satstep/satstep2660/media/noheat1.jpg

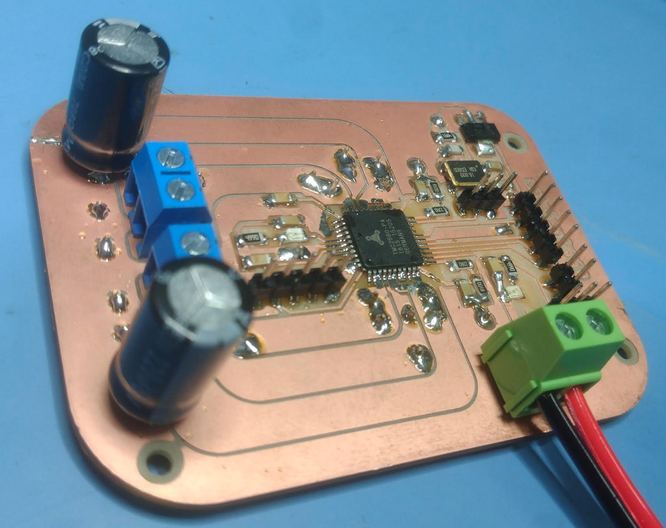
media/noheat1.jpg
