satstep/satstep2660/bom/satstep2660 BOM.ods

Value | Manufacturer Part No | Package | Description | Link | Unit Price $ | Quantity | Price $ | Total price $:
- | TMC2660-PA-T | 44-LQFP | stepper driver IC | digikey (https://www.digikey.com/product-detail/en/trinamic-motion-control-gmbh/TMC2660-PA-T/1460-1062-1-ND/4500217) | 6.98 | 1 | 6.98 | 11.2161
470nF 100V | - | 1206 | smd capacitor | aliexpress (https://www.aliexpress.com/item/100pcs-1206-470nF-0-47uF-100V-10-Thick-Film-Chip-Multilayer-Ceramic-Capacitor/32862247889.html) | 0.03 | 1 | 0.031
100nF 100V | - | 1206 | smd capacitor | aliexpress (https://www.aliexpress.com/item/Free-Shipping-100pcs-lot-1206-SMD-Capacitor-100V-100NF-10-X7R-CL31B104KCFNNNE/32751150463.html) | 0.06 | 3 | 0.1782
10nF 100V | - | 1206 | smd capacitor | aliexpress (https://www.aliexpress.com/item/100pcs-1206-10000pF-10nF-0-01uF-100V-10-Thick-Film-Chip-Multilayer-Ceramic-Capacitor/32860016976.html) | 0.03 | 4 | 0.12
220uF 63V | - | 10x16mm | trough hole capacitor | aliexpress (https://www.aliexpress.com/item/Free-Shipping-20PCS-Electrolytic-capacitor-63V-220UF-10x16mm/32234266260.html) | 0.12 | 2 | 0.239
15pF 100V | - | 1206 | smd capacitor | aliexpress (https://www.aliexpress.com/item/100pcs-1206-15PF-2KV-2000V-5-Thick-Film-Chip-Multilayer-Ceramic-Capacitor/32860906507.html) | 0.04 | 1 | 0.036
green | - | 1206 | smd led | aliexpress (https://www.aliexpress.com/item/Smd-leds-led-smd-red-ray-1206-languang-bright-double-red-red/2031685194.html) | 0.01 | 1 | 0.006
red | - | 1206 | smd led | aliexpress (https://www.aliexpress.com/item/Smd-leds-led-smd-red-ray-1206-languang-bright-double-red-red/2031685194.html) | 0.01 | 1 | 0.006
5V to 3.3V | MCP1703 | SOT223 | smd stepdown regulator | aliexpress (https://www.aliexpress.com/item/MCP1703T-3302E-DB-MCP1703T-3302E-D-MCP1703T-3302E-MCP1703T-3302-3302-10pcs-lot/32762444428.html) | 0.32 | 1 | 0.32
22 | - | 1206 | smd resistor | aliexpress (https://www.aliexpress.com/item/100PCS-1206-SMD-Resistor-5-22-ohm-220-22ohm-free-shipping/32881584288.html) | 0.01 | 2 | 0.0178
4.99K | - | 1206 | smd resistor | aliexpress (https://www.aliexpress.com/item/200pcs-1206-1-SMD-Resistor-4-99k-4-99K-ohm-Chip-Resistors-0-25W-1-4W/32956961040.html) | 0.01 | 1 | 0.01
499 | - | 1206 | smd resistor | aliexpress (https://www.aliexpress.com/item/200pcs-1206-1-SMD-Resistor-499R-499-ohms-ohm-Chip-Resistors-0-25W-1-4W/32960539874.html) | 0.01 | 2 | 0.02
0.1 | - | 1206 | smd resistor | aliexpress (https://www.aliexpress.com/item/200pcs-1-1206-SMD-resistor-0R-10M-1-4W-0-0-1-1-10-100-150/32844350889.html) | 0.01 | 2 | 0.02
16Mhz | XO91050UITA | 7 x 5mm SMD HCMOS | smd oscillator | farnell (https://www.newark.com/euroquartz/16-000mhz-xo91050uita/osc-5x7mm-smd-cer-16-000mhz/dp/15P4131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) | 2.84 | 1 | 2.84
2 poles | KF128-5.08-2P | 5.08mm | screw terminal block | aliexpress (https://www.aliexpress.com/item/100PCS-KF128-5-08-2P-KF128-2Pin-5-08mm-Straight-Pin-PCB-Screw-Terminal-Block-ROHS/32223216761.html) | 0.04 | 3 | 0.1161
40 poles | - | 2.54mm | straight pin headers | aliexpress (https://www.aliexpress.com/item/Free-Shipping-Pins-Multipurpose-Male-Male-5-strips-of-40/32651418137.html) | 0.15 | 1 | 0.146
- | - | 14x14x8mm | aluminum heatsink | aliexpress (https://www.aliexpress.com/item/10pcs-Computer-Cooler-Radiator-Aluminum-Heatsink-Heat-sink-for-Electronic-Chip-Heat-dissipation-Cooling-Pads-14/32890197245.html) | 0.13 | 1 | 0.13
