satstep/satstep2660/eagle/satstep2660.brd

## EAGLE design eagle/satstep2660.brd (2019-05-05)

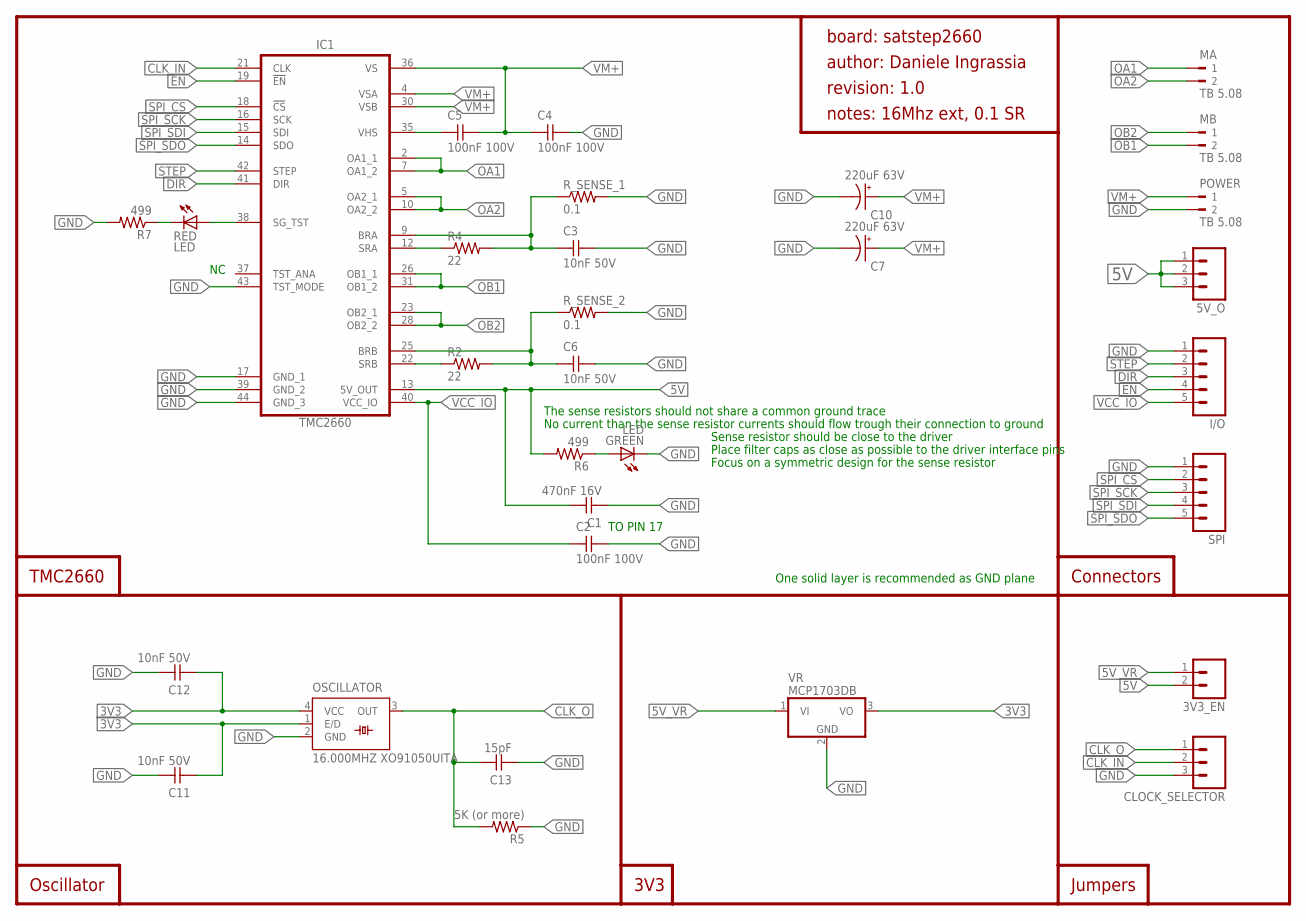
[picture p31: schematic satstep2660.sch]

Parts:
3V3_EN: M02; 02P
5V_O: M03; 03P
C1: 470nF 16V; C1206
C2, C4, C5: 100nF 100V; C1206
C3, C6, C11, C12: 10nF 50V; C1206
C7, C10: 220uF 63V; CPOL-RADIAL-5MM-10MM
C13: 15pF; C1206
CLOCK_SELECTOR: M03; 03P
GREEN: LED; LED1206
I/O: M05; 05P
IC1: TMC2660; TMC_PQFP44_0.8_10X10_TMC236
MA: TB 5.08; WEIDMULLER_PM5.08_2
MB: TB 5.08; WEIDMULLER_PM5.08_2
OSCILLATOR: 16.000MHZ XO91050UITA; SM77H
POWER: TB 5.08; WEIDMULLER_PM5.08_2
R2, R4: 22; R1206
R5: 5K (or more); R1206
R6, R7: 499; R1206
RED: LED; LED1206
R_SENSE_1, R_SENSE_2: 0.1; R1206
SPI: M05; 05P
VR: MCP1703DB; SOT223

Connections:
3V3: C11.1, C12.1, OSCILLATOR.1 (E/D), OSCILLATOR.4 (VCC), VR.3 (VO)
5V: 3V3_EN.2, 5V_O.1, 5V_O.2, 5V_O.3, C1.2, IC1.13 (5V_OUT), R6.2
5V_VR: 3V3_EN.1, VR.1 (VI)
BRA: C3.1, IC1.9 (BRA), R4.2, R_SENSE_1.1
BRB: C6.1, IC1.25 (BRB), R2.2, R_SENSE_2.1
CLK_IN: CLOCK_SELECTOR.2, IC1.21 (CLK)
CLK_O: C13.2, CLOCK_SELECTOR.1, OSCILLATOR.3 (OUT), R5.2
DIR: I/O.3, IC1.41 (DIR)
EN: I/O.4, IC1.19 (!EN)
GND: C1.1, C2.2, C3.2, C4.2, C6.2, C7.-, C10.-, C11.2, C12.2, C13.1, CLOCK_SELECTOR.3, GREEN.2 (C), I/O.1, IC1.17 (GND_1), IC1.39 (GND_2), IC1.43 (TST_MODE), IC1.44 (GND_3), OSCILLATOR.2 (GND), POWER.2, R5.1, R7.2, R_SENSE_1.2, R_SENSE_2.2, SPI.1, VR.2 (GND)
unnamed: C5.1, IC1.35 (VHS)
unnamed: GREEN.1 (A), R6.1
unnamed: IC1.38 (SG_TST), RED.1 (A)
unnamed: R7.1, RED.2 (C)
OA1: IC1.2 (OA1_1), IC1.7 (OA1_2), MA.1
OA2: IC1.5 (OA2_1), IC1.10 (OA2_2), MA.2
OB1: IC1.26 (OB1_1), IC1.31 (OB1_2), MB.2
OB2: IC1.23 (OB2_1), IC1.28 (OB2_2), MB.1
SPI_CS: IC1.18 (!CS!), SPI.2
SPI_SCK: IC1.16 (SCK), SPI.3
SPI_SDI: IC1.15 (SDI), SPI.4
SPI_SDO: IC1.14 (SDO), SPI.5
SRA: IC1.12 (SRA), R4.1
SRB: IC1.22 (SRB), R2.1
STEP: I/O.2, IC1.42 (STEP)
VCC_IO: C2.1, I/O.5, IC1.40 (VCC_IO)
VM+: C4.1, C5.2, C7.+, C10.+, IC1.4 (VSA), IC1.30 (VSB), IC1.36 (VS), POWER.1

Notes on the sheet:
TO PIN 17
The sense resistors should not share a common ground trace
No current than the sense resistor currents should flow trough their connection to ground
One solid layer is recommended as GND plane
TMC2660
Oscillator
3V3
Jumpers
Connectors
Sense resistor should be close to the driver
Place filter caps as close as possible to the driver interface pins
Focus on a symmetric design for the sense resistor
board: satstep2660
author: Daniele Ingrassia
revision: 1.0
notes: 16Mhz ext, 0.1 SR

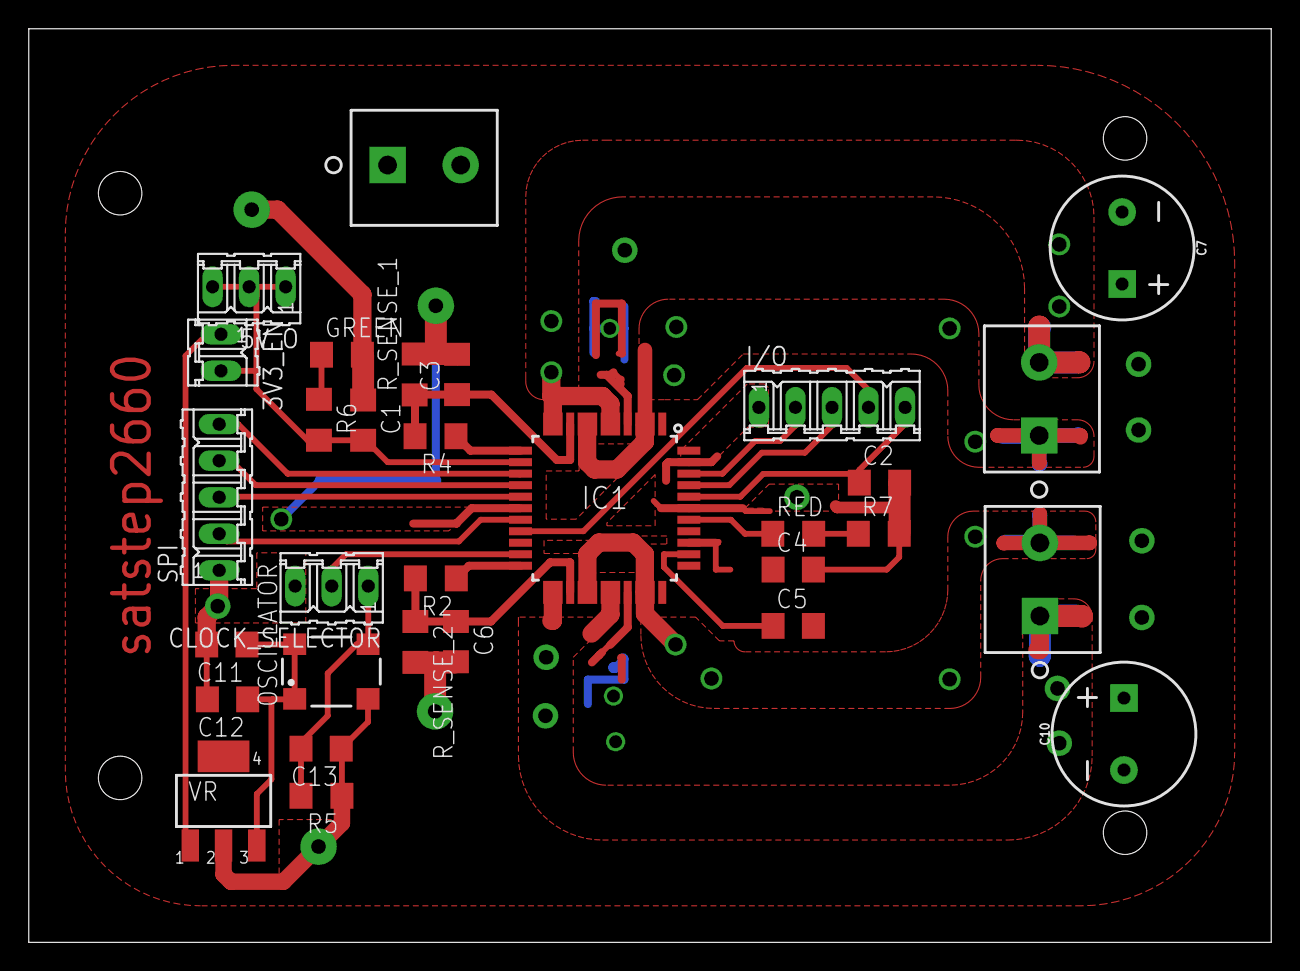
[picture p32: board satstep2660.brd from above]

Board: 2 copper layers, 86.4 x 63.5 mm, 31 parts (0 on the bottom side), 27 nets.
